AllenKon/OSHW-reCamera-Series/Seeed_reCamera_Gimbal/README.md

# reCamera Gimbal Programmable Development Kit V1.0

## Introduction

Welcome to reCamera Gimbal Programmable Development Kit. We provide sample code to debug the gimbal motor's operation and status output. We offer program entry points to drive the gimbal motor using RS485 or CAN, enabling precise control and functionality.

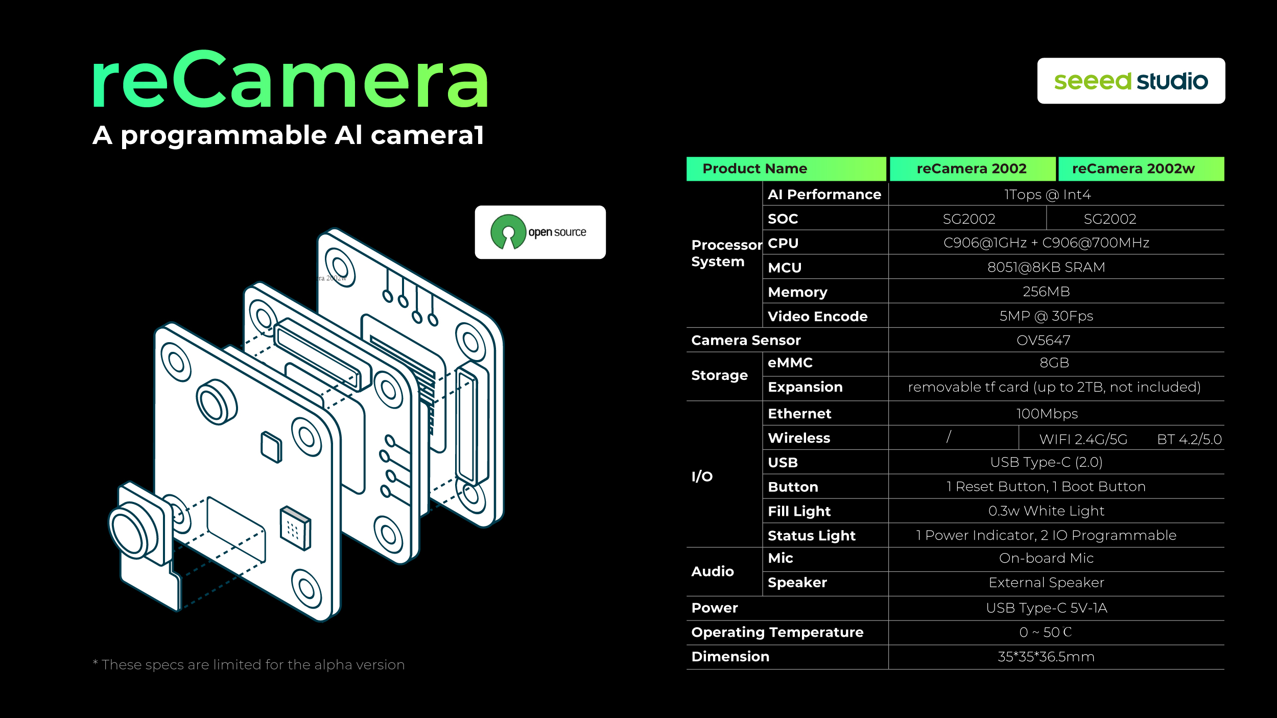
[picture p1: Seeed_reCamera_Gimbal/reCamera_Deploy/MS_Motor/Pic/recamera(1).jpg]
reCamera


## Install

```
pip install -e git+https://github.com/AllenKon/Seeed_reCamera_Gimbal.git#egg=reCamera_Deploy --no-deps
```

## Gimbal Structure & Assembly

You can download the STL file of this gimbal for 3D printing and assemble it. (Url: https://makerworld.com/zh/models/536713) 

### Assembly

None.(Waiting to write)

## Instructions for using

### Motor ID Set

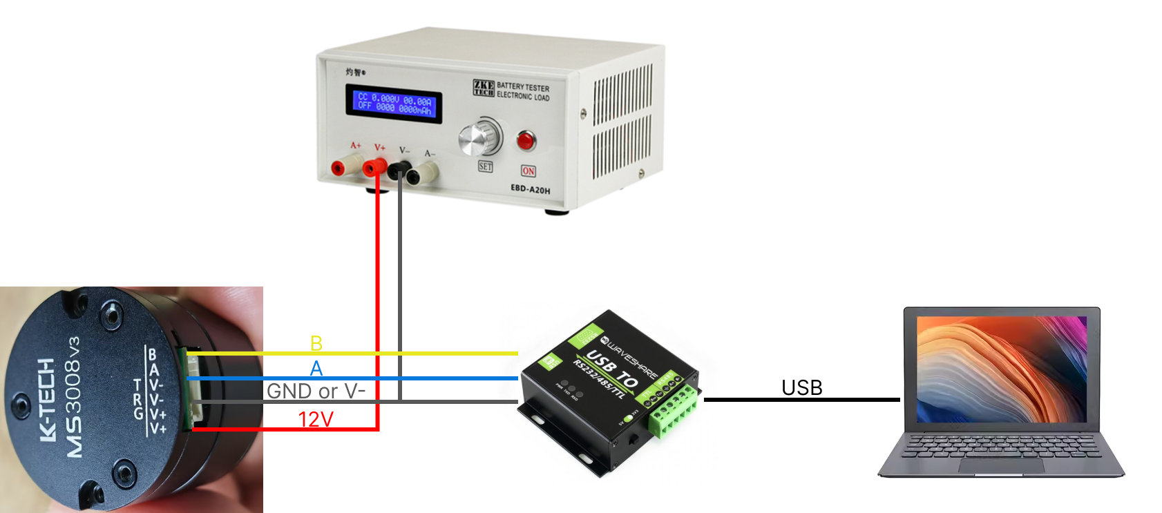
[picture p2: Seeed_reCamera_Gimbal/reCamera_Deploy/MS_Motor/Pic/Connect.png]
Connect of Devices


ID changes can be made using MS_Motor/LK motor tool V2.35.exe. Connect the PC (Windows) to the USB-RS485 module, with A, B, and GND of the USB-RS485 module connected to A, B, and V- of the motor. Connect the positive and negative terminals of a 12V power supply to V+ and V- of the motor to enable parameter changes. For further instructions on using LK motor tool V2.35.exe, refer to MS_Motor/Upper_monitor_motor_debuging_instruction.pdf. 

Only two motors are used in this head, so it is sufficient to set the IDs of the two motors to 01 and 02 respectively.

### USB-RS485 Analyzer

If you want a RS485 Bus Analyzer to debug your RS485 Bus, this [USB-RS485 Analyzer](https://www.seeedstudio.com/USB-TO-RS232--RS485--TTL-Industrial-Isolated-Converter-p-3231.html) is recommended.

<p float="left">
  
</p>

## Hardware Overview

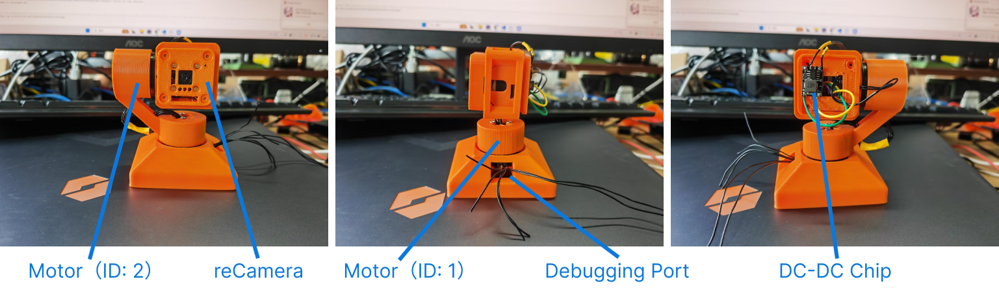
[picture p3: Seeed_reCamera_Gimbal/reCamera_Deploy/MS_Motor/Pic/Hardware_Overview.png]
Hardware Overview


The actual internal wiring diagram is as follows.

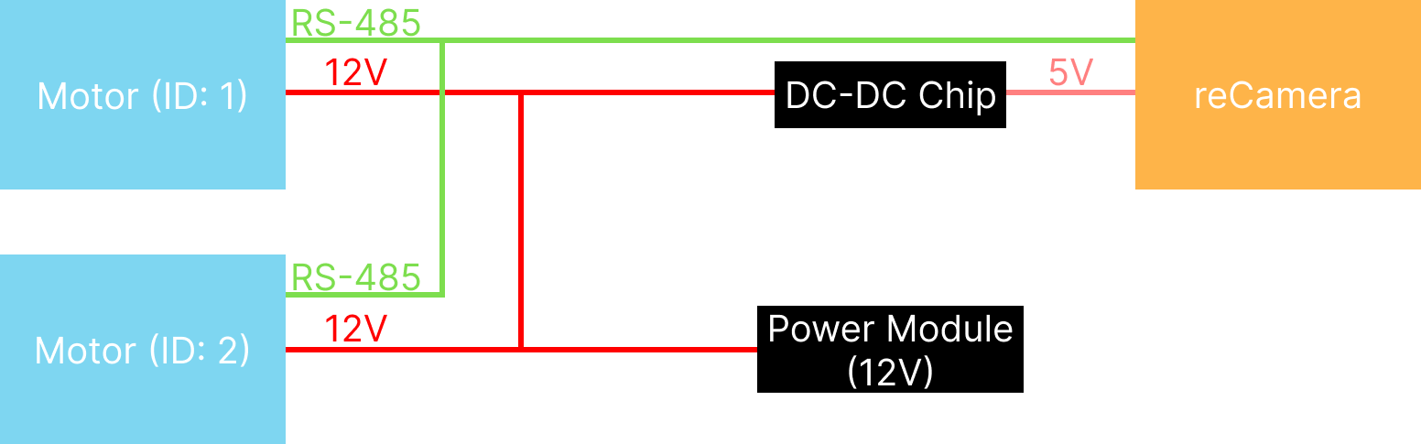
[picture p4: Seeed_reCamera_Gimbal/reCamera_Deploy/MS_Motor/Pic/Hardware_Wiring_Overview.png]
Hardware Overview


You can use the Debugging Port connections to control the motor and communicate with the reCamera via the upper monitor. Alternatively, you can control the motor directly through the reCamera.

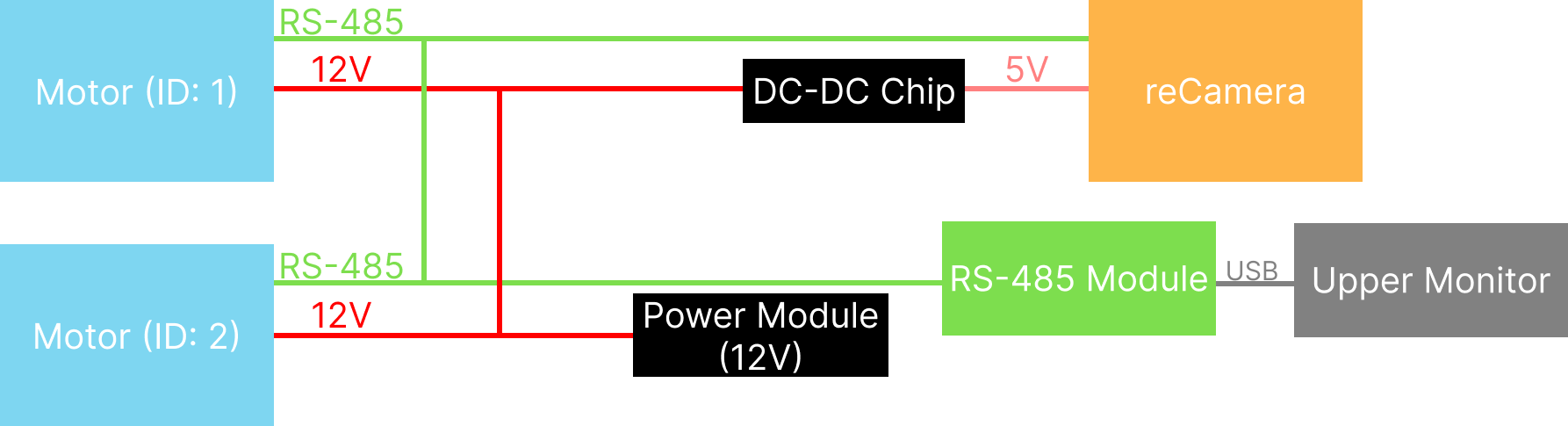
[picture p5: Seeed_reCamera_Gimbal/reCamera_Deploy/MS_Motor/Pic/Upper_Wiring_Overview.png]
Hardware Overview


## Deploy in reCamera

This step requires [TinyCC](https://community.milkv.io/t/tinycc-milkv-duo-c/271) to be installed on reCamera. 

Open a terminal in the directory where Deploy_Linux.c is stored.

```
scp ./Deploy_Linux.c root@192.168.42.1:~/
```

```
ssh root@192.168.42.1
```
The serial port name can be obtained by terminal. It is usually ttyS0.

```
ls /dev/ttyS*
```

Open Deploy_Linux.c and change the serial port name on line 160. 

```
vi ./Deploy_Linux.c
```

<p float="left">
  
</p>

Compile Deploy_Linux.c and run it.

```
cd ~/
tcc -o test Deploy_Linux.c
./test
```

<p float="left">
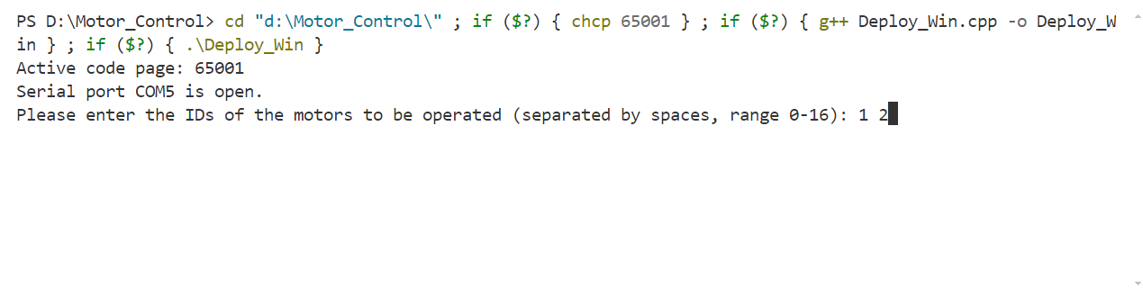
[picture p6: Seeed_reCamera_Gimbal/reCamera_Deploy/MS_Motor/Pic/TF2.png]
  
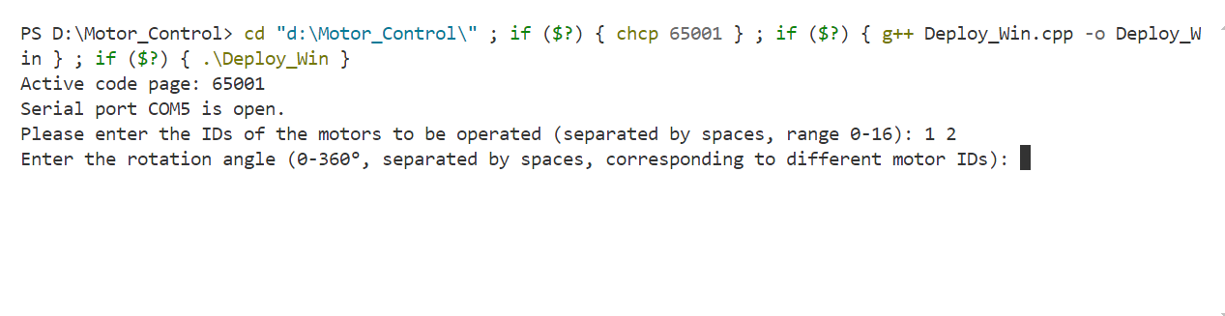
[picture p7: Seeed_reCamera_Gimbal/reCamera_Deploy/MS_Motor/Pic/TF3.png]
  
</p>

## Deploy to Upper Monitor

### Upper Monitor Control

#### Python

Open a terminal in the root directory while making sure Python is installed.

```
python Deploy_Python.py
```

Then just enter the angle (0-360 degrees) for both motors.

<p float="left">
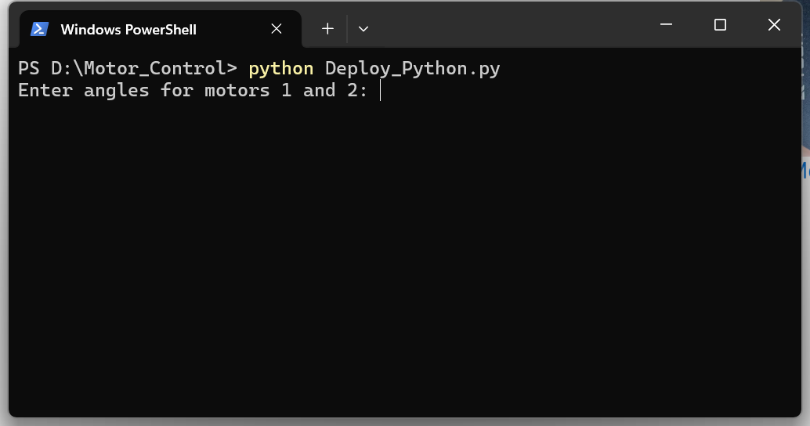
[picture p8: Seeed_reCamera_Gimbal/reCamera_Deploy/MS_Motor/Pic/TF1.jpg]
  
</p>

#### C++

Make sure your system ([Win](https://cloud.tencent.com/developer/article/1500352) or Linux) has g++ installed, open a terminal in the root directory.

*Win*

Open Deploy_Win.cpp and change the serial port name on line 125. The serial port name can be obtained by opening the Device Manager.

```
g++ Deploy_Win.cpp -o Deploy_Win.exe
```

*Linux*

Open Deploy_Linux.cpp and change the serial port name on line 160. The serial port name can be obtained by terminal.

```
ls /dev/ttyUSB*
```

```
g++ Deploy_Linux.cpp -o Deploy_Linux
./Deploy_Linux
```

<p float="left">
  
  
</p>

----
