AllenKon/OSHW-reCamera-Series/B3_Gyro/B3readme.md

## S1_OV5647

**The project contains the 3D housing and circuit design files of the Gimbal base board.**

🎈🎈🎈🎈🎈🎈🎈🎈🎈

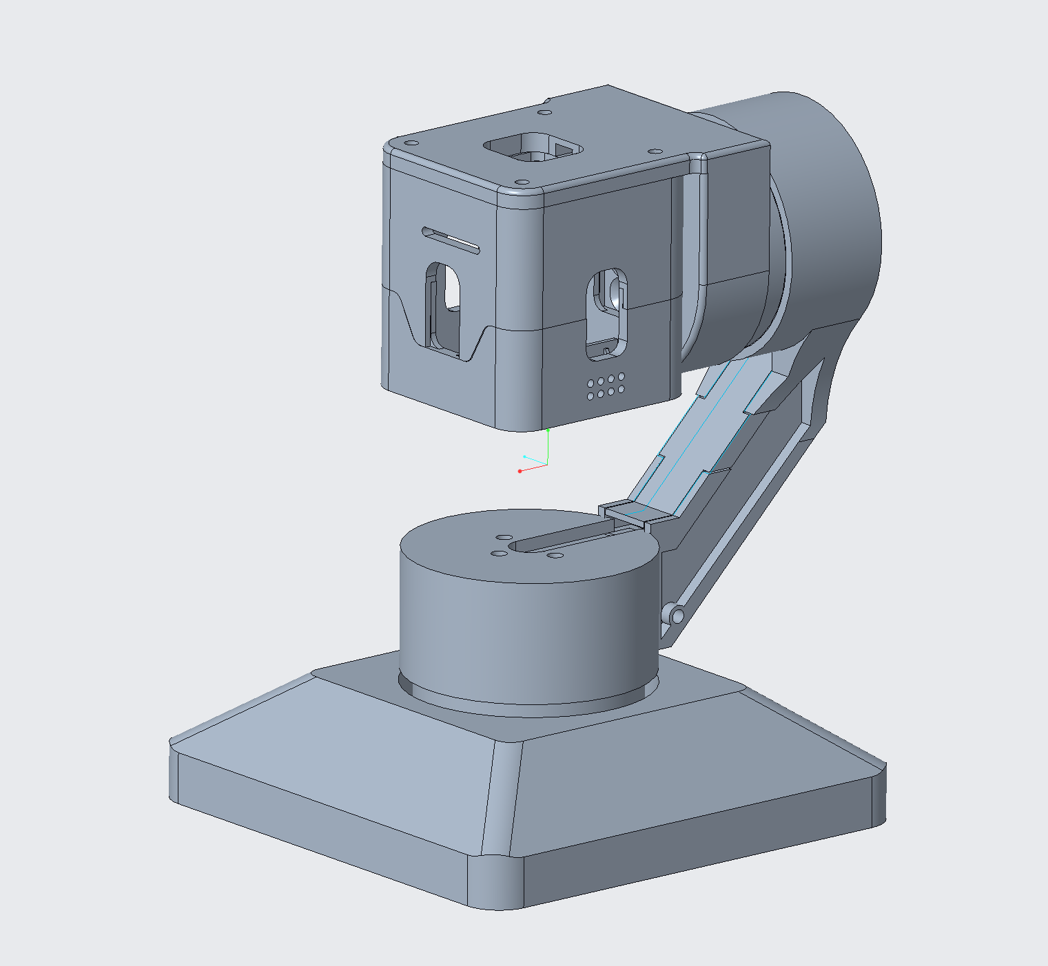
[picture p9: B3_Gyro/static/Gimbal.png]


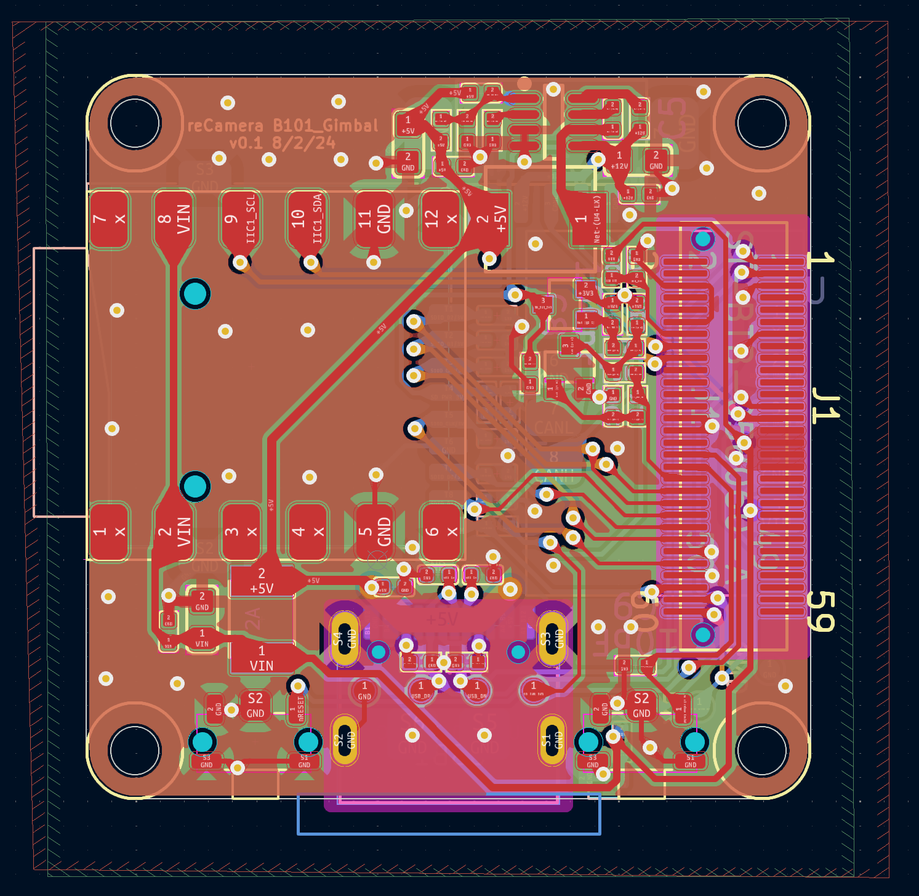
[picture p10: B3_Gyro/static/reCamera_Gimbal_PCB.png]
