AllenKon/OSHW-reCamera-Series/Seeed_reCamera_Gimbal/reCamera_Deploy/MS_Motor/Pic/MS3008_Motor.jpg

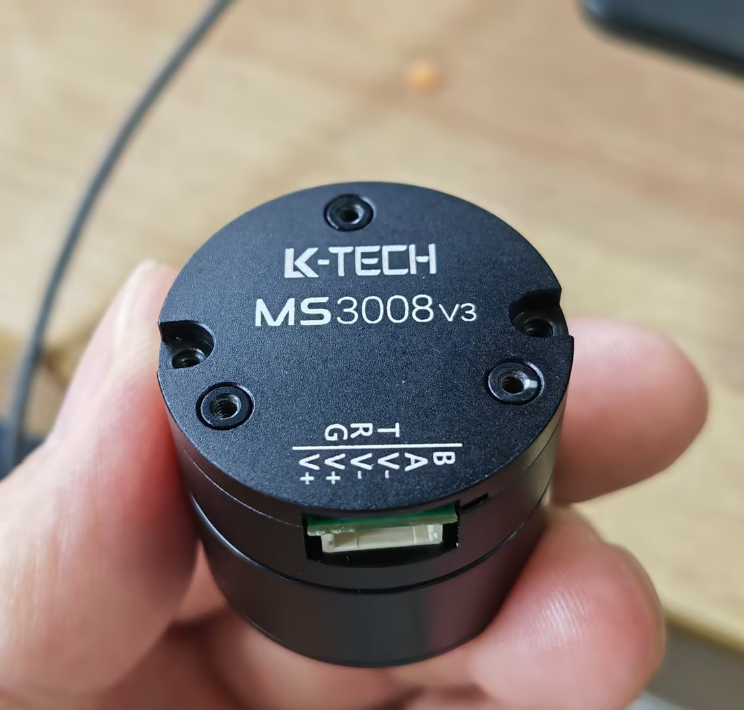
Seeed_reCamera_Gimbal/reCamera_Deploy/MS_Motor/Pic/MS3008_Motor.jpg
