AllenKon/OSHW-reCamera-Series/Seeed_reCamera_Gimbal/reCamera_Deploy/MS_Motor/Pic/reCamera_Font_View.jpg

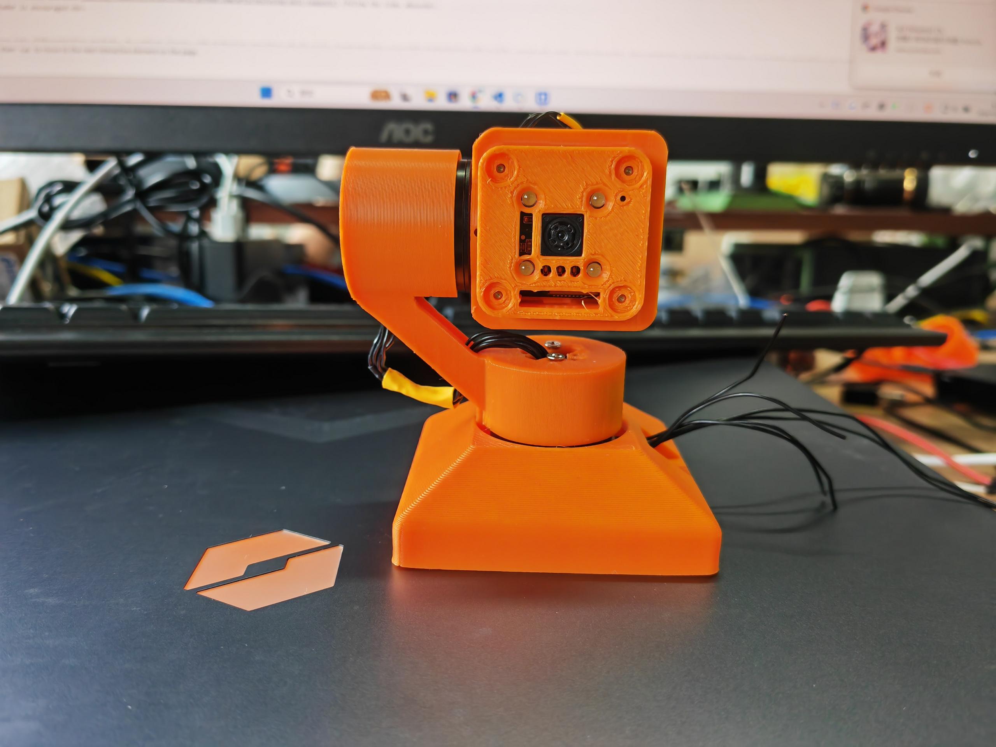
Seeed_reCamera_Gimbal/reCamera_Deploy/MS_Motor/Pic/reCamera_Font_View.jpg
