AllenKon/OSHW-reCamera-Series/Seeed_reCamera_Gimbal/reCamera_Deploy/MS_Motor/Pic/企业微信截图_17205932447109.png

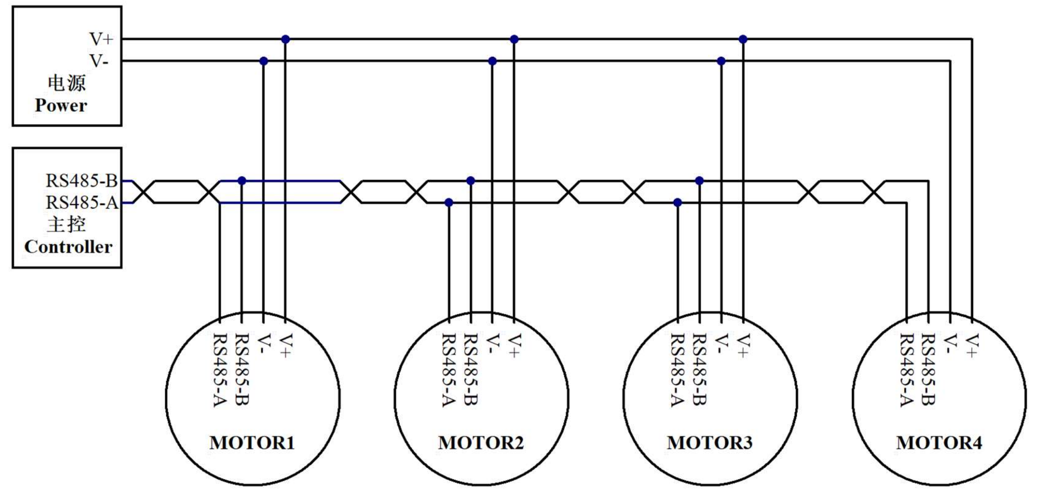
Seeed_reCamera_Gimbal/reCamera_Deploy/MS_Motor/Pic/企业微信截图_17205932447109.png
