AllenKon/OSHW-reCamera-Series/statics/B1_Default.png

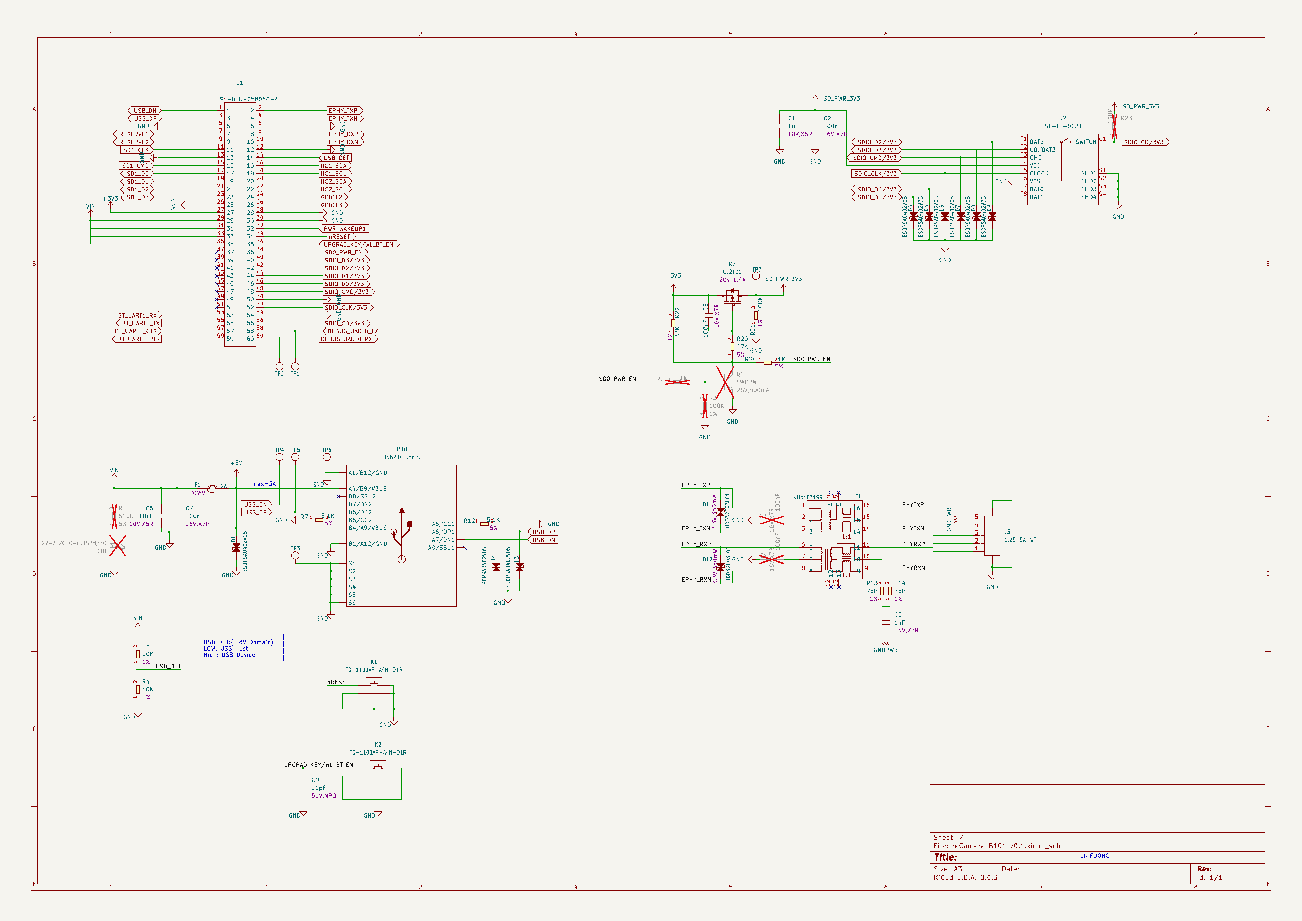
statics/B1_Default.png
