AllenKon/OSHW-reCamera-Series/Seeed_reCamera_Gimbal/reCamera_Deploy/MS_Motor/Upper_monitor_motor_debuging_instruction.pdf

# 上位机

# Lingkong Motor Tool V2.35

# 中英文简介

# Setting参数设置

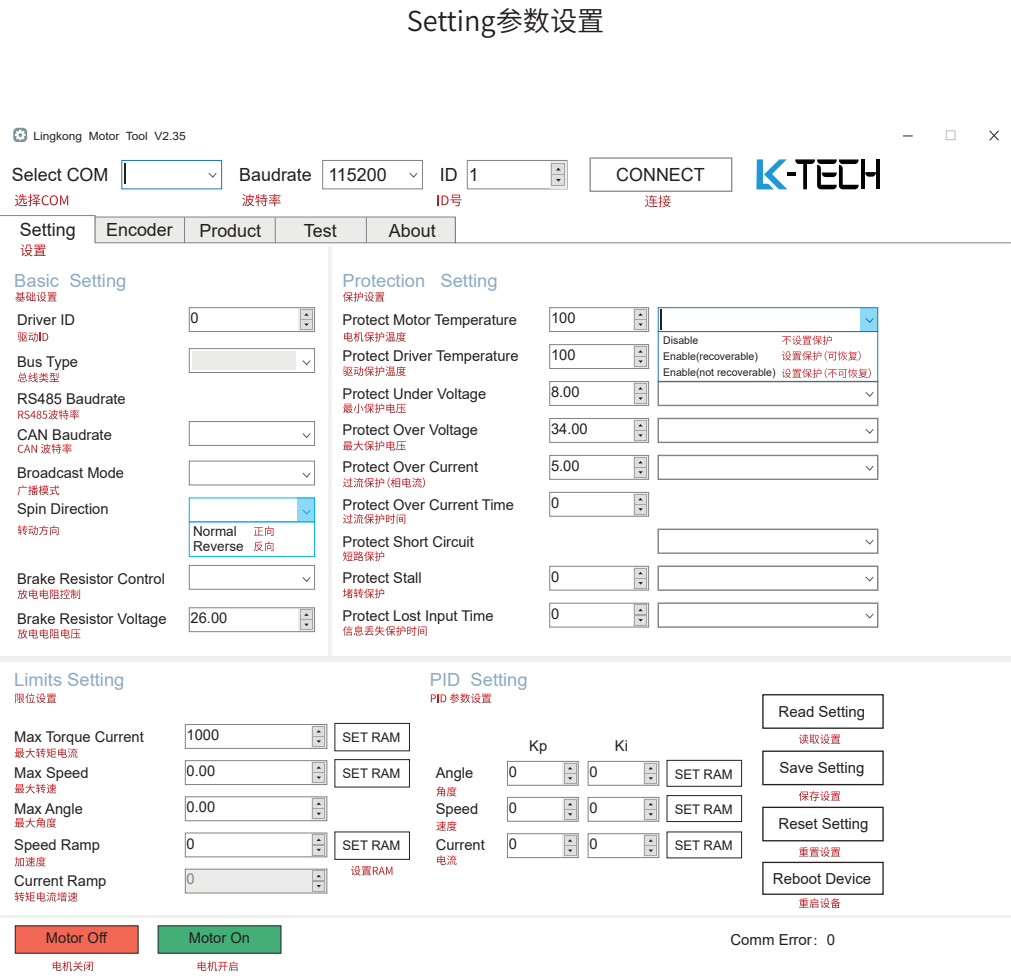
[picture p33: page 2]
Select COM; Baudrate; CONNECT; Setting; Encoder; Driver ID; Bus Type; RS485 Baudrate; CAN Baudrate; Broadcast Mode; Spin Direction; Normal Reverse; Max Torque Current; Angle; Speed; Current; Max Speed; Speed Ramp; Current Ramp; Motor Off; Motor On; Max Angle; Basic Setting; Protection Setting; Limits Setting; PID Setting; Product; Test; About; SET RAM; Read Setting; Reset Setting; Reboot Device; Comm Error：0; Save Setting

Lingkong Motor Tool V2.35

Protect Motor Temperature
Protect Driver Temperature
Protect Under Voltage
Protect Over Voltage
Protect Over Current
Protect Over Current Time
Protect Short Circuit
Protect Stall
Protect Lost Input Time

Disable
Enable(recoverable)
Enable(not recoverable)

Brake Resistor Control

Brake Resistor Voltage

Lingkong Motor Tool V2.35
Select COM | Baudrate | 115200 | ID | 1 | CONNECT

### Setting

Motor Poles | Reduction Ratio
| Reducer/Encoder Align Value
| Reducer Zero Position

28

Encoder Type

Encoder Position

Motor/Encoder Offset

Motor/Encoder Align Ratio

Motor/Encoder Align Voltage | Align
Motor Zero Position(Rom) | Set

Motor Phase Sequence

Motor / Encoder Setting | Redycer / Encoder Setting
Product | Test | About

8

2.50

### Encoder

0

0

0

0

0 | Set

Save

Read

Clear

# Encoder编码设置

Lingkong Motor Tool V2.35
Select COM | Baudrate | 115200 | ID | 1 | CONNECT

### Setting

### Motor

### Motor version

### Driver

| Hardware version
| Firmware version

### Chip ID

### Test About

### Encoder

Read Info

Open File

Download

### Product

# Product产品更新

Lingkong Motor Tool V2.35
Select COM | Baudrate | 115200 | ID | 1 | CONNECT

### Setting

Product | About

### Encoder

Save

### Test

Clear Text

Read Multi Loop Angle | Clear Motor Loops

Read State 1

### Control mode

### Torque Current

### Torque Control Speed Control Multi Loop Angle Control1 Multi Loop Angle Control2 Single Loop Angle Control1 Single Loop Angle Control2 Increment Angle Control1 Increment Angle Control2

### Speed Angle Rev

Read State 2

Clear Error

Send

Read State 3

Brake | Brake Release | Read Single Loop Angle | Set Motor Zero(RAM)

Motor Stop

Motor Restore

Bus Voltage | 0 V
| 0 0 dps
| 0
| 0
| 0
| 0

UVP
Motor Temp
Torque Current
Speed
Encoder
IA
IB
IC

Bus Voltage
0 ℃ | OVP
| DTP MTP OCP SCP MSP LIP

0
360.00
0.00

# Test 电机测试
