AllenKon/OSHW-reCamera-Series/B3_Gyro/PCB/reCamera B101_Gimbal v0.1.kicad_pcb

## KiCad design B3_Gyro/PCB/reCamera B101_Gimbal v0.1.kicad_pcb (2024-08-09)

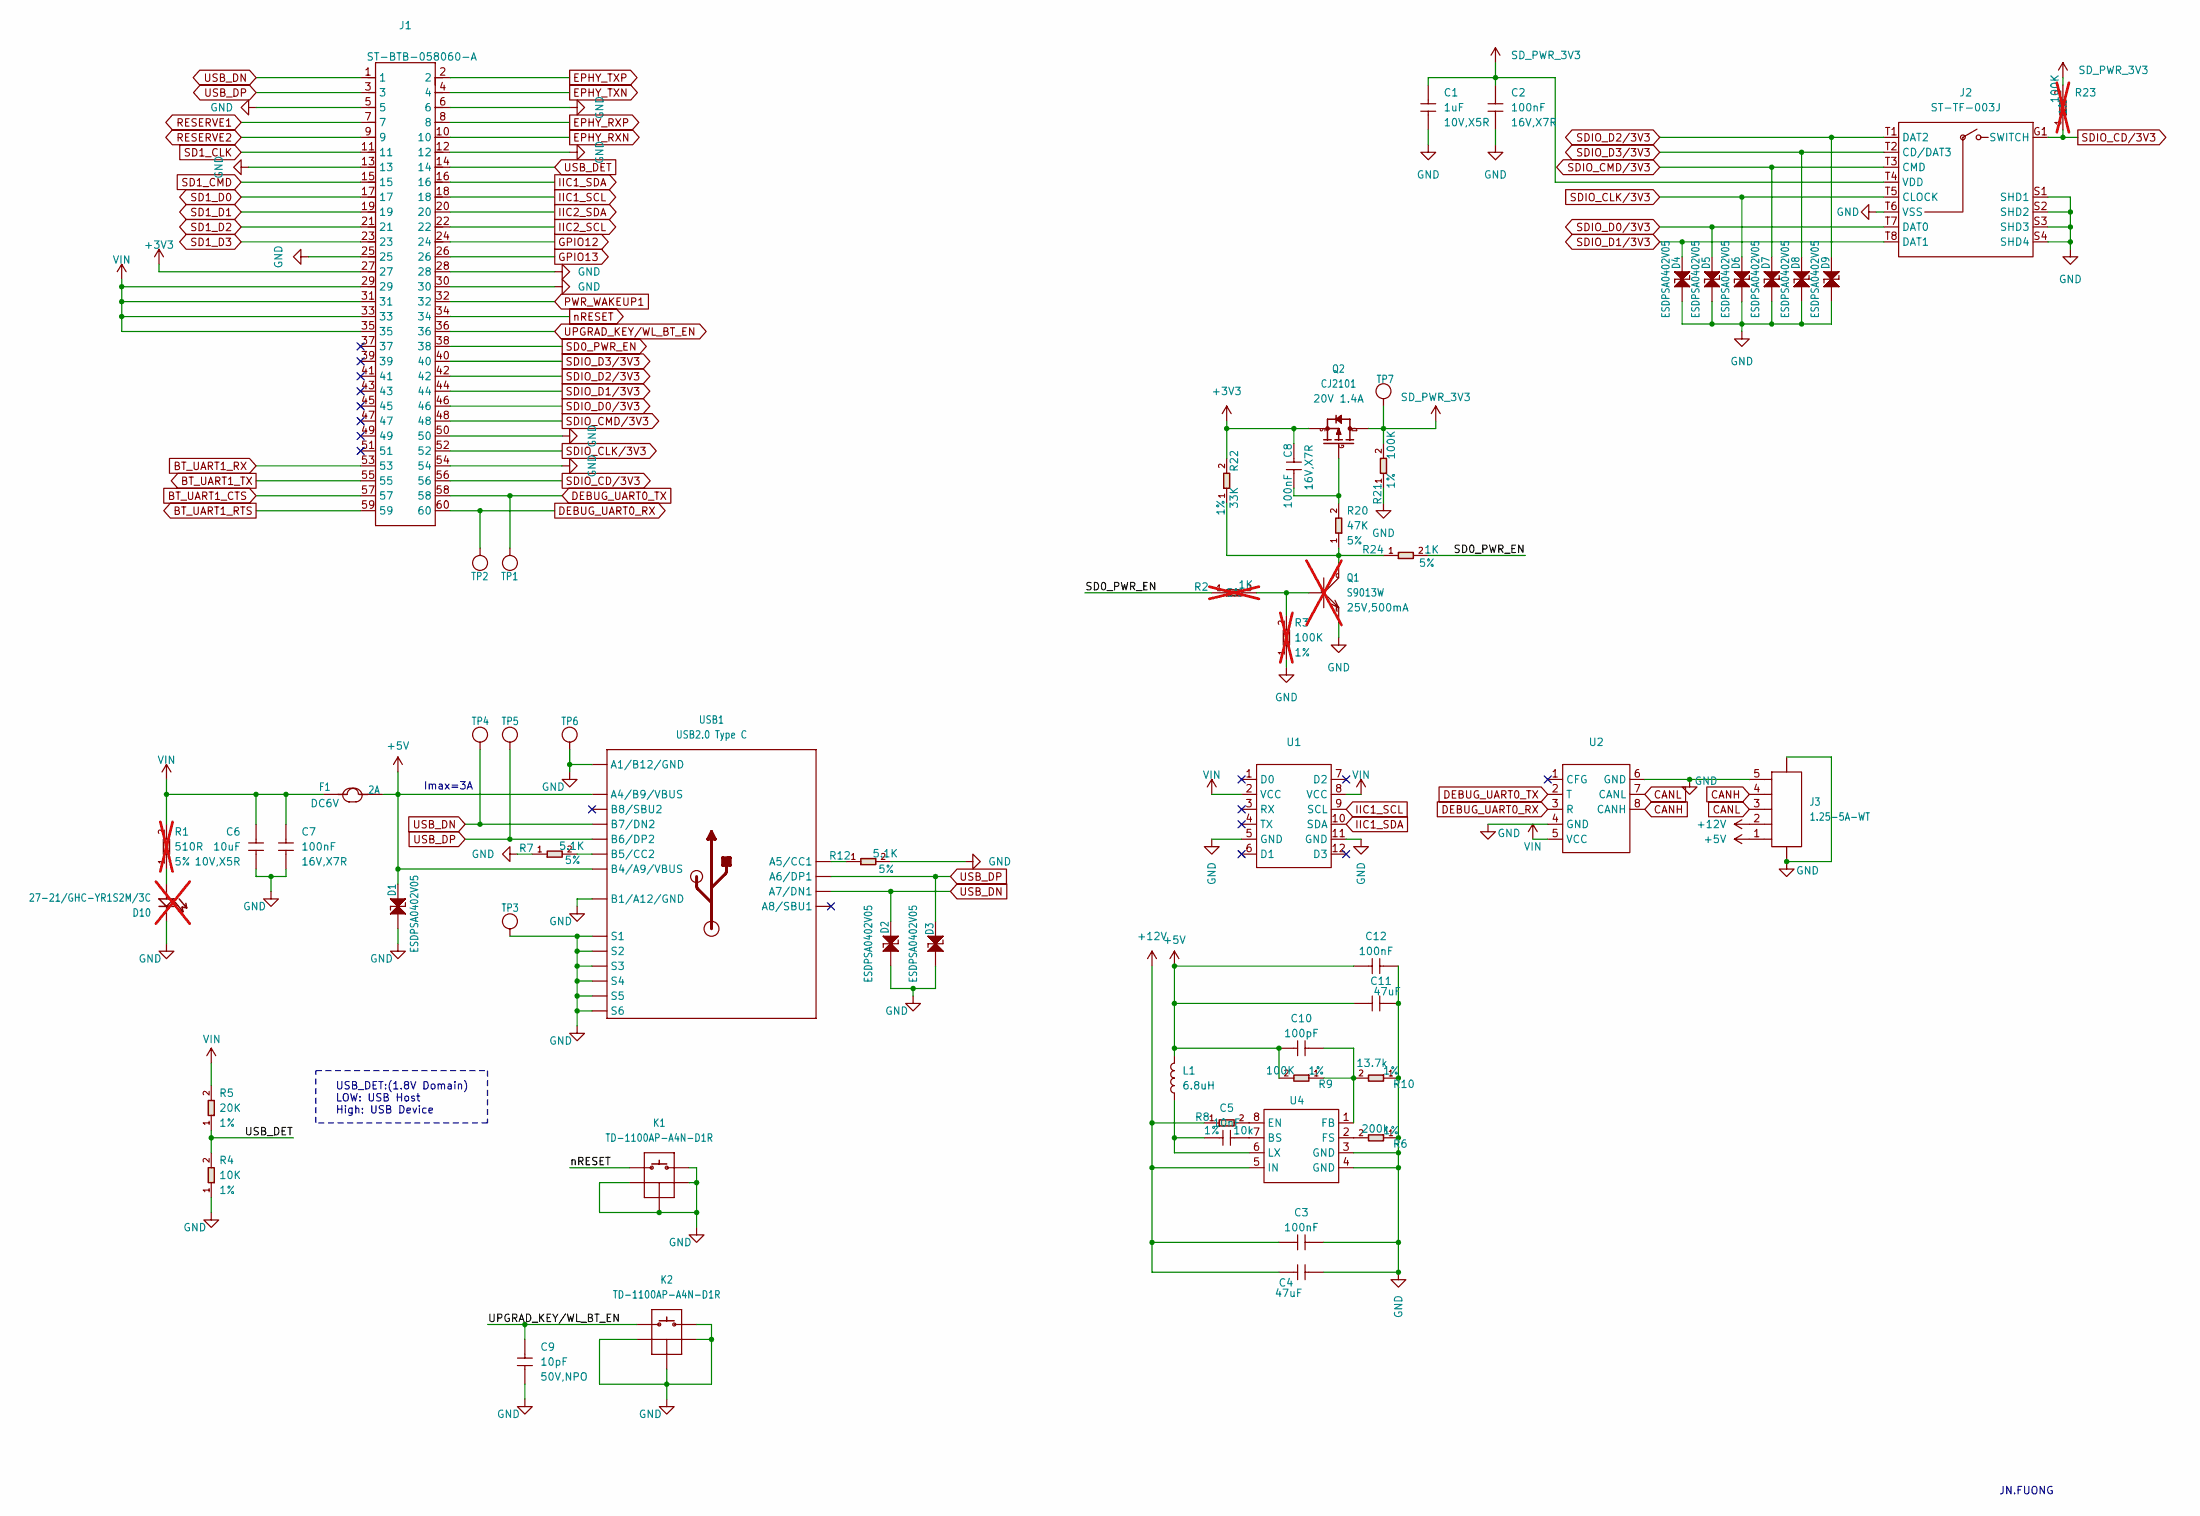
[picture p34: schematic reCamera B101_Gimbal v0.1.kicad_sch]

Parts:
C1: 1uF; C0402; Voltage Rating 10V,X5R; MPN CC0402KRX5R6BB105
C2, C3, C7, C8, C12: 100nF; C0402; Voltage Rating 16V,X7R; MPN CC0402KRX7R7BB104
C4, C11: 47uF; C0603; Voltage Rating 10V,X5R; MPN CC0603KRX5R6BB106
C5: 10nF; C0402; Voltage Rating 16V,X7R; MPN CC0402KRX7R7BB104
C6: 10uF; C0603; Voltage Rating 10V,X5R; MPN CC0603KRX5R6BB106
C9: 10pF; C0402; Voltage Rating 50V,NPO; MPN CC0402JRNPO9BN100
C10: 100pF; C0402; Voltage Rating 16V,X7R; MPN CC0402KRX7R7BB104
D1, D2, D3, D4, D5, D6, D7, D8, D9: ESDPSA0402V05; ESD-0402; MPN ESDPSA0402V05
D10: 27-21/GHC-YR1S2M/3C; LED2-0.6X1.7MM; MPN 27-21/GHC-YR1S2M/3C; not fitted
F1: 2A; F1210; Rating DC6V; MPN SMD1210R200SF
J1: ST-BTB-058060-A; BTB60-Male-Female-0.5-17.7x4.4mm; MPN ST-BTB-058060-A
J2: ST-TF-003J; MICRO-SD-CARD-9P; MPN ST-TF-003J
J3: 1.25-5A-WT; JST5_2P_1d25_7_9x4_3x3_4mm; MPN 1.25-5A-WT
K1, K2: TD-1100AP-A4N-D1R; SW5-SMD-4.56X2.3X1.9MM; MPN TD-1100AP-A4N-D1R
L1: 6.8uH
Q1: S9013W; SOT-323; Rating 25V,500mA; MPN S9013W; not fitted
Q2: CJ2101; SOT-323; Rating 20V 1.4A; MPN CJ2101
R1: 510R; R0402; Power Rating 5%; MPN RC0402JR-07510RL; not fitted
R2: 1K; R0402; Power Rating 5%; MPN RC0402JR-071KL; not fitted
R3, R23: 100K; R0402; Power Rating 1%; MPN RC0402FR-07100KL; not fitted
R4: 10K; R0402; Power Rating 1%; MPN RC0402FR-0710KL
R5: 20K; R0402; Power Rating 1%; MPN RC0402FR-0720KL
R6: 200k; R0402; Power Rating 1%; MPN RC0402FR-07100KL
R7, R12: 5.1K; R0402; Power Rating 5%; MPN RC0402JR-075K1L
R8: 10k; R0402; Power Rating 1%; MPN RC0402FR-07100KL
R9, R21: 100K; R0402; Power Rating 1%; MPN RC0402FR-07100KL
R10: 13.7k; R0402; Power Rating 1%; MPN RC0402FR-07100KL
R20: 47K; R0402; Power Rating 5%; MPN RC0402JR-0747KL
R22: 33K; R0402; Power Rating 1%; MPN RC0402FR-0733KL
R24: 1K; R0402; Power Rating 5%; MPN RC0402JR-071KL
TP1, TP2, TP3, TP4, TP5, TP6, TP7: Test Point; TP-D35MIL; Part Type Test Point
U1: WT9011G4K
U2: TTL-CAN
U4: SY8303AIC
USB1: USB2.0 Type C; USB2.0-TYPE-C; MPN UBF31-0171

Connections:
+3V3: C8.1, J1.27, Q2.2 (S), R22.2
+5V: C10.1, C11.1, C12.1, D1.1, F1.2, J3.1, L1.2, R9.2, USB1.A4_B9 (A4/B9/VBUS), USB1.B4_A9 (B4/A9/VBUS)
+12V: C3.1, C4.1, J3.2, R8.1, U4.5 (IN)
BT_UART1_CTS: J1.57
BT_UART1_RTS: J1.59
BT_UART1_RX: J1.53
BT_UART1_TX: J1.55
CANH: J3.4, U2.8 (CANH)
CANL: J3.3, U2.7 (CANL)
DEBUG_UART0_RX: J1.60, TP2.1 (T), U2.3 (R)
DEBUG_UART0_TX: J1.58, TP1.1 (T), U2.2 (T)
EPHY_RXN: J1.10
EPHY_RXP: J1.8
EPHY_TXN: J1.4
EPHY_TXP: J1.2
GND: C1.2, C2.2, C3.2, C4.2, C6.2, C7.2, C9.2, C11.2, C12.2, D1.2, D2.2, D3.2, D4.2, D5.2, D6.2, D7.2, D8.2, D9.2, D10.2 (-), J1.5, J1.6, J1.12, J1.13, J1.25, J1.28, J1.30, J1.50, J1.54, J2.S1 (SHD1), J2.S2 (SHD2), J2.S3 (SHD3), J2.S4 (SHD4), J2.T6 (VSS), J3.5, J3.6, J3.7, K1.2, K1.S1, K1.S2, K1.S3, K2.2, K2.S1, K2.S2, K2.S3, Q1.2 (E), R3.1, R4.1, R6.1, R7.1, R10.1, R12.2, R21.1, TP3.1 (T), TP6.1 (T), U1.5 (GND), U1.11 (GND), U2.4 (GND), U2.6 (GND), U4.3 (GND), U4.4 (GND), USB1.A1_B12 (A1/B12/GND), USB1.B1_A12 (B1/A12/GND), USB1.S1, USB1.S2, USB1.S3, USB1.S4, USB1.S5, USB1.S6
GPIO12: J1.24
GPIO13: J1.26
IIC1_SCL: J1.18, U1.9 (SCL)
IIC1_SDA: J1.16, U1.10 (SDA)
IIC2_SCL: J1.22
IIC2_SDA: J1.20
unnamed: D10.1 (+), R1.1
unnamed: Q1.1 (B), R2.2, R3.2
unnamed: Q1.3 (C), R20.1, R22.1, R24.1
unnamed: C8.2, Q2.1 (G), R20.2
unnamed: C5.2, U4.7 (BS)
unnamed: R8.2, U4.8 (EN)
unnamed: C10.2, R9.1, R10.2, U4.1 (FB)
unnamed: R6.2, U4.2 (FS)
unnamed: C5.1, L1.1, U4.6 (LX)
unnamed: R12.1, USB1.A5 (A5/CC1)
unnamed: R7.2, USB1.B5 (B5/CC2)
PWR_WAKEUP1: J1.32
RESERVE1: J1.7
RESERVE2: J1.9
SD0_PWR_EN: J1.38, R2.1, R24.2
SD1_CLK: J1.11
SD1_CMD: J1.15
SD1_D0: J1.17
SD1_D1: J1.19
SD1_D2: J1.21
SD1_D3: J1.23
SDIO_CD/3V3: J1.56, J2.G1 (SWITCH), R23.1
SDIO_CLK/3V3: D6.1, J1.52, J2.T5 (CLOCK)
SDIO_CMD/3V3: D7.1, J1.48, J2.T3 (CMD)
SDIO_D0/3V3: D5.1, J1.46, J2.T7 (DAT0)
SDIO_D1/3V3: D4.1, J1.44, J2.T8 (DAT1)
SDIO_D2/3V3: D9.1, J1.42, J2.T1 (DAT2)
SDIO_D3/3V3: D8.1, J1.40, J2.T2 (CD/DAT3)
SD_PWR_3V3: C1.1, C2.1, J2.T4 (VDD), Q2.3 (D), R21.2, R23.2, TP7.1 (T)
UPGRAD_KEY/WL_BT_EN: C9.1, J1.36, K2.1
USB_DET: J1.14, R4.2, R5.1
USB_DN: D2.1, J1.1, TP4.1 (T), USB1.A7 (A7/DN1), USB1.B7 (B7/DN2)
USB_DP: D3.1, J1.3, TP5.1 (T), USB1.A6 (A6/DP1), USB1.B6 (B6/DP2)
VIN: C6.1, C7.1, F1.1, J1.29, J1.31, J1.33, J1.35, R1.2, R5.2, U1.2 (VCC), U1.8 (VCC), U2.5 (VCC)
nRESET: J1.34, K1.1

Notes on the sheet:
JN.FUONG
USB_DET:(1.8V Domain) LOW: USB Host High: USB Device
Imax=3A

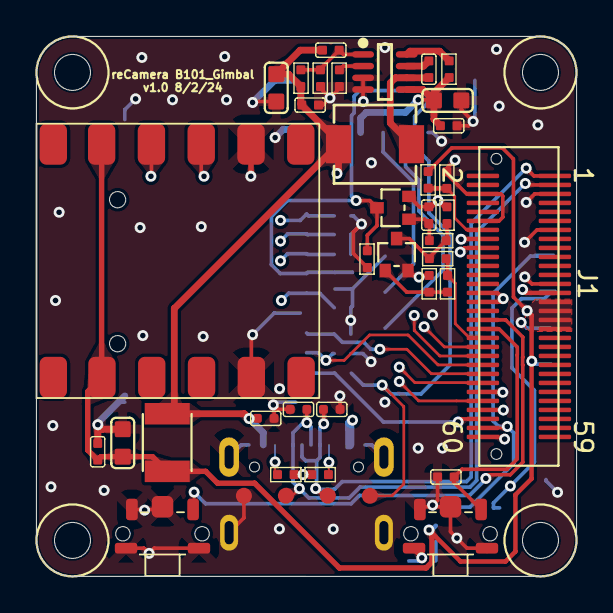
[picture p35: board reCamera B101_Gimbal v0.1.kicad_pcb from above]

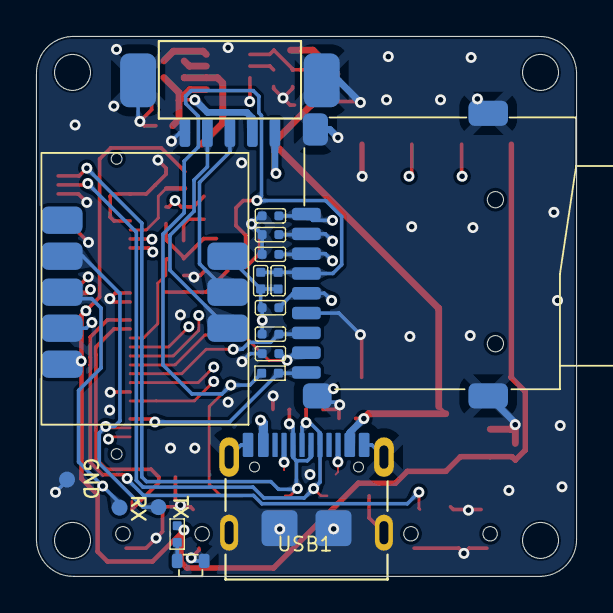
[picture p36: board reCamera B101_Gimbal v0.1.kicad_pcb from below]

Board: 4 copper layers, 30.0 x 30.0 mm, 58 parts (18 on the bottom side), 36 nets.
